andresgumu/bt-audio-receiver/images/rough-breadboardPic.JPEG

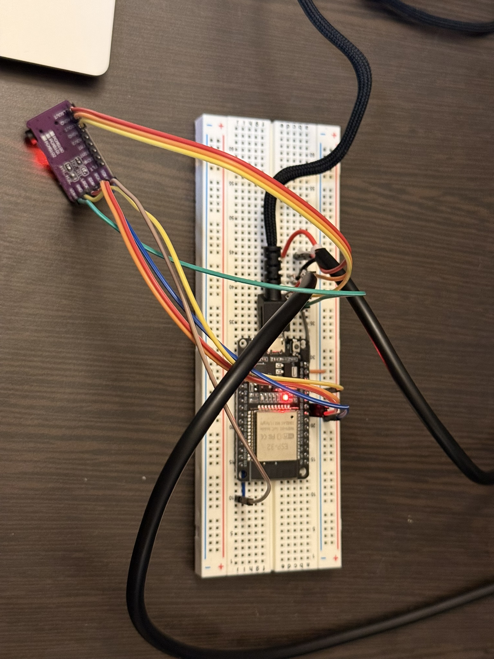
images/rough-breadboardPic.JPEG
