andresgumu/bt-audio-receiver/(commit log)

2026-06-30 Document I2S protocol advantages over SPI
2026-06-30 Enhance I2S protocol documentation with SPI comparison
2026-07-02 Update LOGBOOK with soldering experiences and fixes
2026-08-09 Add migration note for PCB design documentation
2026-08-09 added some images of the PCB
2026-08-09 added pcb images
2026-08-09 Enhance README with PCB image
2026-08-22 Add DAC pin reference documentation
    Added detailed pin reference information for charge pump, analog output, hardware configuration, digital audio interface, and digital supply.
